LuckyResistor/PlantWateringSensor/Schema/PlantSensorHead.pdf

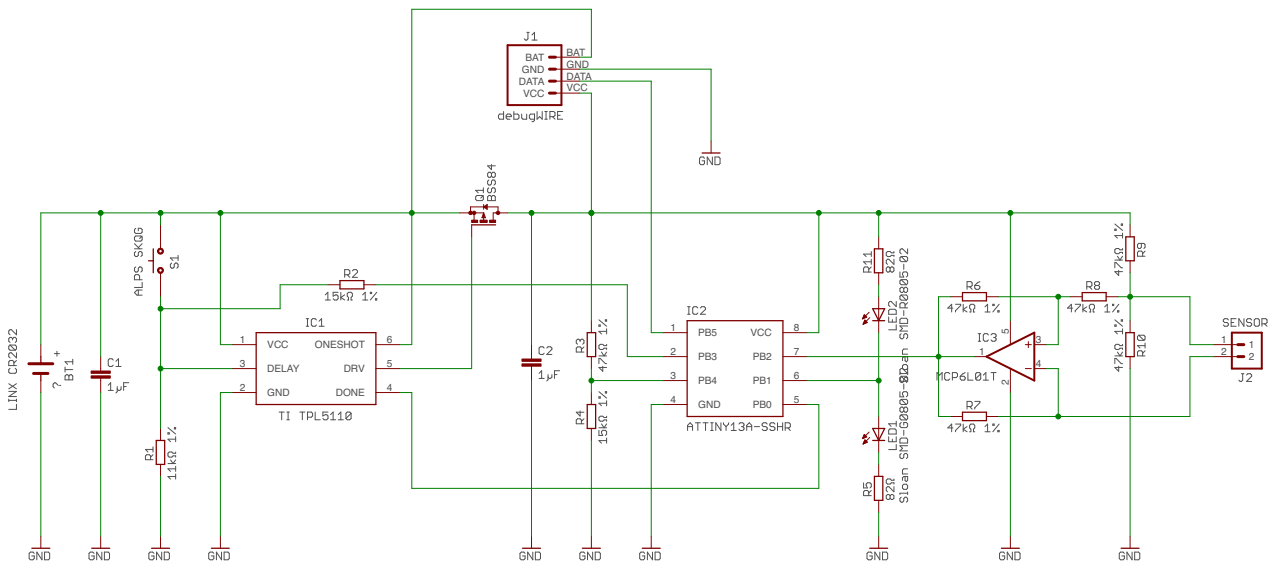
[picture p1: page 1]
