LuckyResistor/PlantWateringSensor/Eagle/PlantSensorHead.brd

## EAGLE design Eagle/PlantSensorHead.brd (2017-08-23)

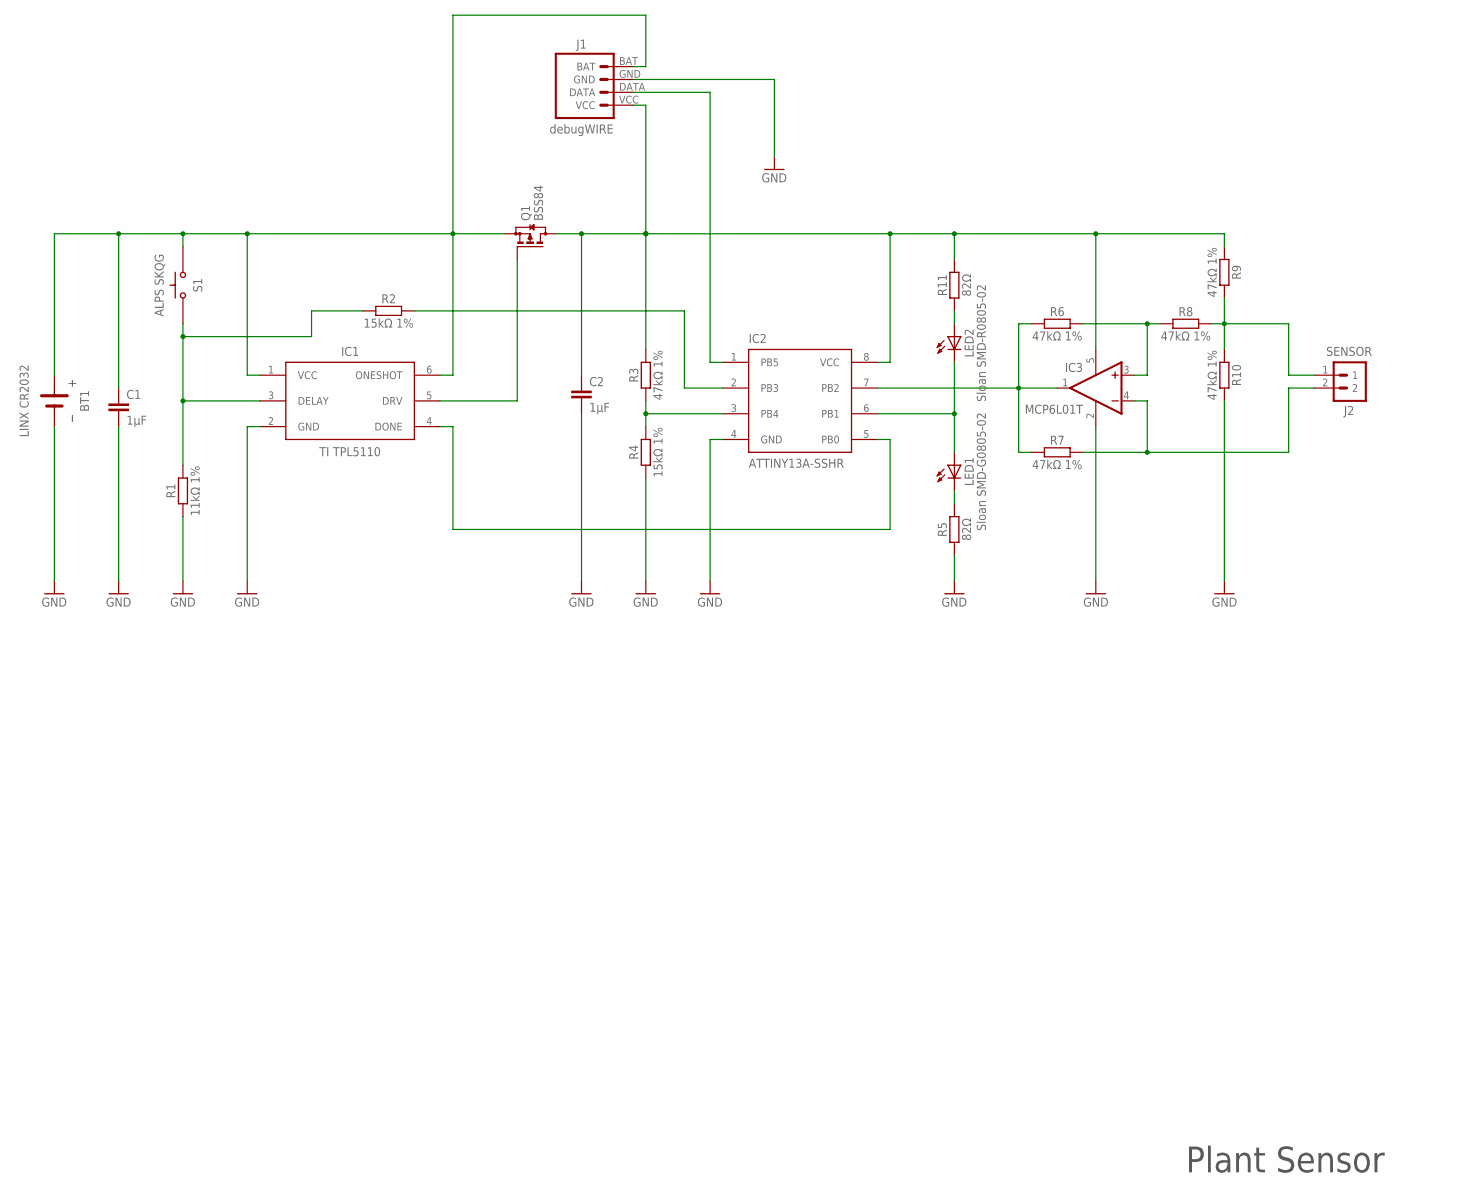
[picture p2: schematic PlantSensorHead.sch]

Parts:
BT1: LINX CR2032; LINX-BAT-HLD-001
C1, C2: 1µF; CAPACITOR-0805-MURATA-GRM-21
IC1: TI TPL5110; SOT23-6L
IC2: ATTINY13A-SSHR; SO08_015_JEDEC
IC3: MCP6L01T; SOT23-5
J1: debugWIRE; CON-PADS-DEBUG-WIRE-50
J2: SENSOR; CON_PADS_2XWIRE
LED1: Sloan SMD-G0805-02; LED-0805-SLOAN
LED2: Sloan SMD-R0805-02; LED-0805-SLOAN
Q1: BSS84; SOT23
R1: 11kΩ 1%; RESISTOR-0805-KOA-RK73-2A
R2, R4: 15kΩ 1%; RESISTOR-0805-KOA-RK73-2A
R3, R6, R7, R8, R9, R10: 47kΩ 1%; RESISTOR-0805-KOA-RK73-2A
R5, R11: 82Ω; RESISTOR-0805-KOA-RK73-2A
S1: ALPS SKQG; ALPS_SKQGAKE010

Connections:
BTN: IC1.3 (DELAY), R1.2, R2.1, S1.1, S1.2 (1)
C_FREQ: IC2.7 (PB2), IC3.1 (OUT), R6.2, R7.2
DONE: IC1.4 (DONE), IC2.5 (PB0)
GND: BT1.GND, C1.2, C2.2, IC1.2 (GND), IC2.4 (GND), IC3.2 (V-), J1.GND, R1.1, R4.1, R5.1, R10.1
LED: IC2.6 (PB1), LED1.A, LED2.C
unnamed: LED2.A, R11.1
unnamed: LED1.C, R5.2
unnamed: IC1.5 (DRV), Q1.1 (G)
unnamed: IC2.2 (PB3), R2.2
unnamed: IC3.3 (+IN), R6.1, R8.2
RST: IC2.1 (PB5), J1.DATA
SENS1A: J2.1, R8.1, R9.1, R10.2
SENS2A: IC3.4 (-IN), J2.2, R7.1
VBR: IC2.3 (PB4), R3.1, R4.2
VCCB: BT1.VDD1 (VDD), BT1.VDD2 (VDD), C1.1, IC1.1 (VCC), IC1.6 (ONESHOT), J1.BAT, Q1.2 (S), S1.3 (2), S1.4 (2)
VCCM: C2.1, IC2.8 (VCC), IC3.5 (V+), J1.VCC, Q1.3 (D), R3.2, R9.2, R11.2

Notes on the sheet:
Plant Sensor

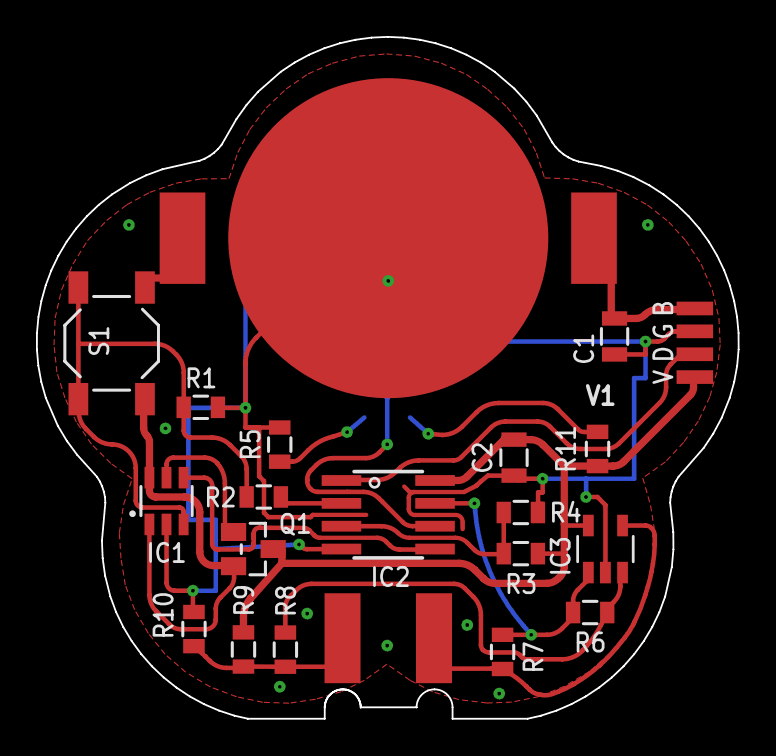
[picture p3: board PlantSensorHead.brd from above]

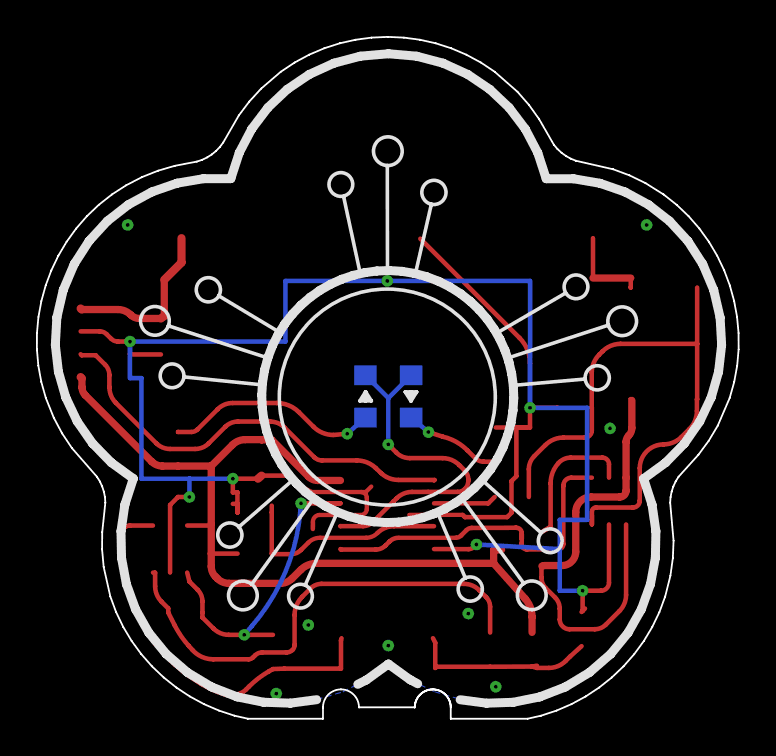
[picture p4: board PlantSensorHead.brd from below]

Board: 2 copper layers, 39.0 x 37.9 mm, 23 parts (2 on the bottom side), 16 nets.
