LuckyResistor/PlantWateringSensor/Eagle/PlantSensorFoot.brd

## EAGLE design Eagle/PlantSensorFoot.brd (2017-08-23)

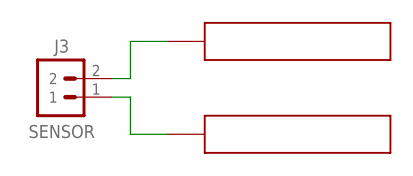
[picture p5: schematic PlantSensorFoot.sch]

Parts:
CP1, CP2: CAP_PAD_5X30; CAP_PLATE_5X30
J3: SENSOR; CON_PADS_2XWIRE

Connections:
SENS1B: CP2.1, J3.1
SENS2B: CP1.1, J3.2

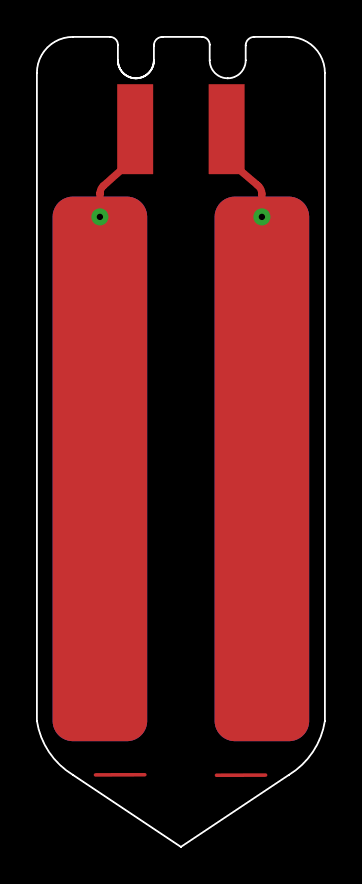
[picture p6: board PlantSensorFoot.brd from above]

Board: 2 copper layers, 16.0 x 45.0 mm, 3 parts (0 on the bottom side), 2 nets.
