LuckyResistor/PlantWateringSensor/(notices)

Notices in the files:
Eagle/PlantSensorFoot.brd:
(c)2017 by Lucky Resistor. https://luckyresistor.me
Licensed under CERN OHL v.1.2 or later
Firmware/src/Logic.cpp:
You may redistribute and modify this documentation under the terms of
the CERN OHL v.1.2. (http://ohwr.org/cernohl). This documentation is
